mmicko/workshop_badge/badge.kicad_pcb

## KiCad design badge.kicad_pcb (2018-02-12)

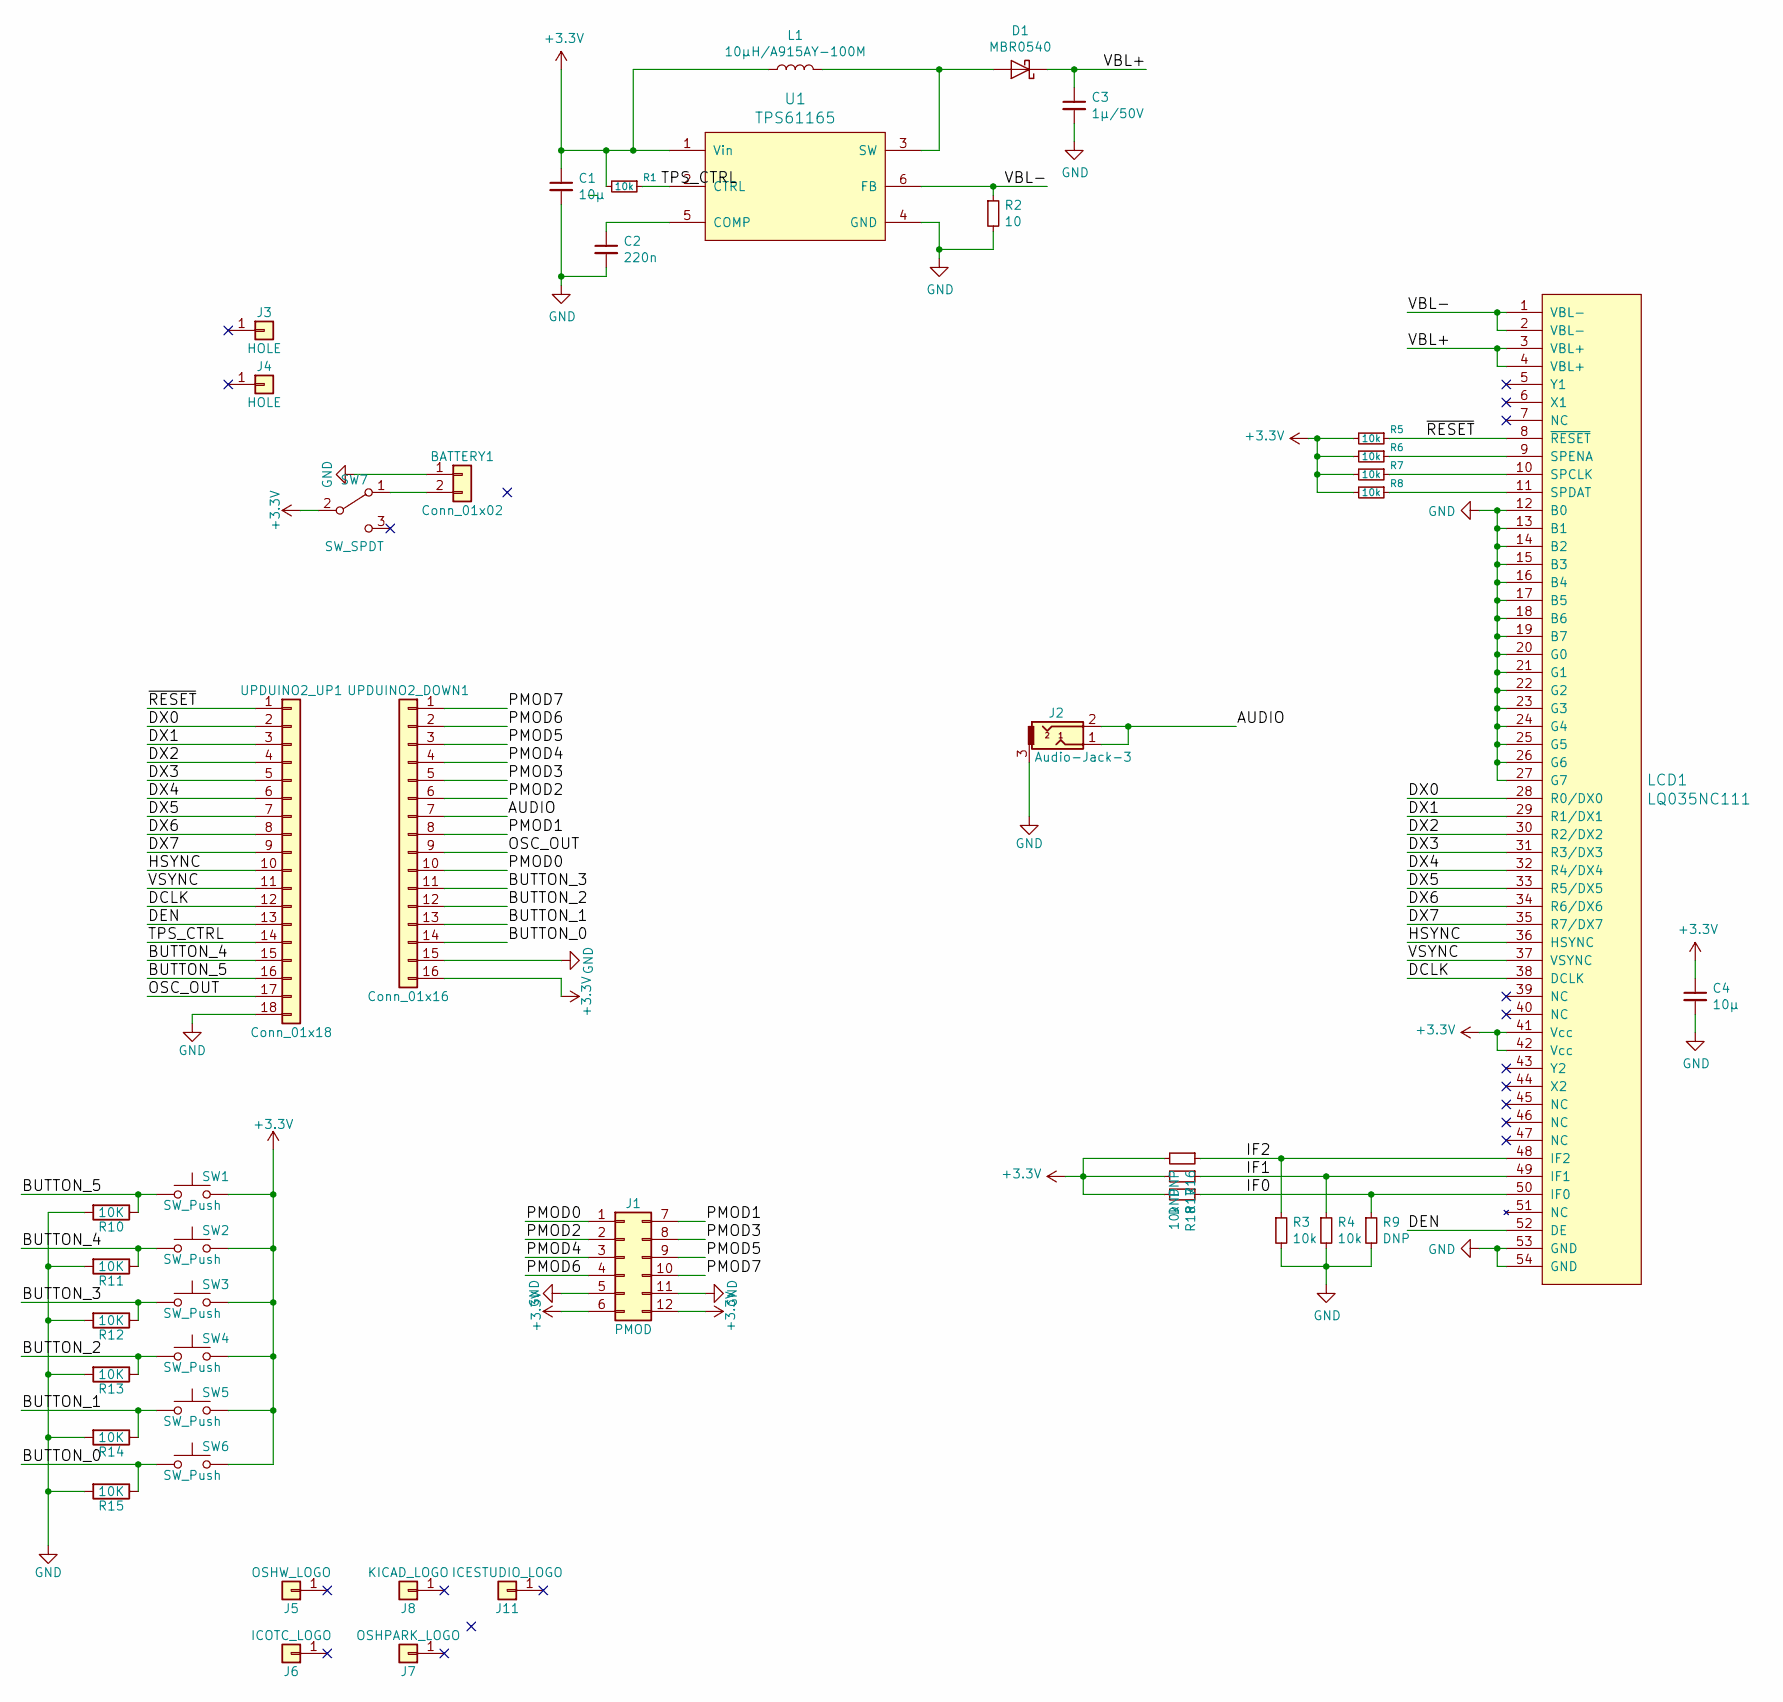
[picture p1: schematic badge.sch, FPGA Workshop Badge for Hackaday Belgrade 2018]

Parts:
BATTERY1: Conn_01x02; Pin_Header_Straight_1x02_Pitch2.54mm
C1, C4: 10µ; C_0805
C2: 220n; C_0603
C3: 1µ/50V; C_0805
D1: MBR0540; D_SOD-123
J1: PMOD; Pin_Header_Angled_2x06_Pitch2.54mm_PMOD
J2: Audio-Jack-3; AUDIO_JACK_3.5mm
J3, J4: HOLE; MountingHole_3.2mm_M3
J5: OSHW_LOGO; OSHW-Logo2_24.3x20mm_SilkScreen
J6: ICOTC_LOGO; ICOTC
J7: OSHPARK_LOGO; OSHPARK
J8: KICAD_LOGO; KiCad-Logo_12mm_SilkScreen
J11: ICESTUDIO_LOGO; ICESTUDIO
L1: 10µH/A915AY-100M; muRata_L_2020
LCD1: LQ035NC111; MOLEX_51296-5494_54pin_0.5mm_BTM
R1, R3, R4, R5, R6, R7, R8, R18: 10k; R_0603
R2: 10; R_0603
R9, R16, R17: DNP; R_0603
R10, R11, R12, R13, R14, R15: 10K; R_0603
SW1, SW2, SW3, SW4, SW5, SW6: SW_Push; SW_PUSH-12mm
SW7: SW_SPDT; SW_CuK_OS102011MA1QN1_SPDT_Angled
U1: TPS61165; SOT-23-6
UPDUINO2_DOWN1: Conn_01x16; Pin_Header_Straight_1x16_Pitch2.54mm
UPDUINO2_UP1: Conn_01x18; Pin_Header_Straight_1x18_Pitch2.54mm

Connections:
+3V3: C1.1, C4.1, J1.6, J1.12, L1.1, LCD1.41 (Vcc), LCD1.42 (Vcc), R1.2, R5.2, R6.2, R7.2, R8.2, R16.2, R17.2, R18.2, SW1.2, SW2.2, SW3.2, SW4.2, SW5.2, SW6.2, SW7.2 (B), U1.1 (Vin), UPDUINO2_DOWN1.16
/AUDIO: J2.1, J2.2, UPDUINO2_DOWN1.7
/BUTTON_0: R15.1, SW6.1, UPDUINO2_DOWN1.14
/BUTTON_1: R14.1, SW5.1, UPDUINO2_DOWN1.13
/BUTTON_2: R13.1, SW4.1, UPDUINO2_DOWN1.12
/BUTTON_3: R12.1, SW3.1, UPDUINO2_DOWN1.11
/BUTTON_4: R11.1, SW2.1, UPDUINO2_UP1.15
/BUTTON_5: R10.1, SW1.1, UPDUINO2_UP1.16
/DCLK: LCD1.38 (DCLK), UPDUINO2_UP1.12
/DEN: LCD1.52 (DE), UPDUINO2_UP1.13
/DX0: LCD1.28 (R0/DX0), UPDUINO2_UP1.2
/DX1: LCD1.29 (R1/DX1), UPDUINO2_UP1.3
/DX2: LCD1.30 (R2/DX2), UPDUINO2_UP1.4
/DX3: LCD1.31 (R3/DX3), UPDUINO2_UP1.5
/DX4: LCD1.32 (R4/DX4), UPDUINO2_UP1.6
/DX5: LCD1.33 (R5/DX5), UPDUINO2_UP1.7
/DX6: LCD1.34 (R6/DX6), UPDUINO2_UP1.8
/DX7: LCD1.35 (R7/DX7), UPDUINO2_UP1.9
/HSYNC: LCD1.36 (HSYNC), UPDUINO2_UP1.10
/IF0: LCD1.50 (IF0), R9.1, R18.1
/IF1: LCD1.49 (IF1), R4.1, R17.1
/IF2: LCD1.48 (IF2), R3.1, R16.1
/OSC_OUT: UPDUINO2_DOWN1.9, UPDUINO2_UP1.17
/PMOD0: J1.1, UPDUINO2_DOWN1.10
/PMOD1: J1.7, UPDUINO2_DOWN1.8
/PMOD2: J1.2, UPDUINO2_DOWN1.6
/PMOD3: J1.8, UPDUINO2_DOWN1.5
/PMOD4: J1.3, UPDUINO2_DOWN1.4
/PMOD5: J1.9, UPDUINO2_DOWN1.3
/PMOD6: J1.4, UPDUINO2_DOWN1.2
/PMOD7: J1.10, UPDUINO2_DOWN1.1
/TPS_CTRL: R1.1, U1.2 (CTRL), UPDUINO2_UP1.14
/VBL+: C3.1, D1.1 (K), LCD1.3 (VBL+), LCD1.4 (VBL+)
/VBL-: LCD1.1 (VBL-), LCD1.2 (VBL-), R2.1, U1.6 (FB)
/VSYNC: LCD1.37 (VSYNC), UPDUINO2_UP1.11
/~RESET: LCD1.8 (~RESET), R5.1, UPDUINO2_UP1.1
GND: BATTERY1.1, C1.2, C2.2, C3.2, C4.2, J1.5, J1.11, J2.3, LCD1.12 (B0), LCD1.13 (B1), LCD1.14 (B2), LCD1.15 (B3), LCD1.16 (B4), LCD1.17 (B5), LCD1.18 (B6), LCD1.19 (B7), LCD1.20 (G0), LCD1.21 (G1), LCD1.22 (G2), LCD1.23 (G3), LCD1.24 (G4), LCD1.25 (G5), LCD1.26 (G6), LCD1.27 (G7), LCD1.53 (GND), LCD1.54 (GND), R2.2, R3.2, R4.2, R9.2, R10.2, R11.2, R12.2, R13.2, R14.2, R15.2, U1.4 (GND), UPDUINO2_DOWN1.15, UPDUINO2_UP1.18
unnamed: BATTERY1.2, SW7.1 (A)
unnamed: C2.1, U1.5 (COMP)
unnamed: D1.2 (A), L1.2, U1.3 (SW)
unnamed: LCD1.9 (SPENA), R6.1
unnamed: LCD1.10 (SPCLK), R7.1
unnamed: LCD1.11 (SPDAT), R8.1

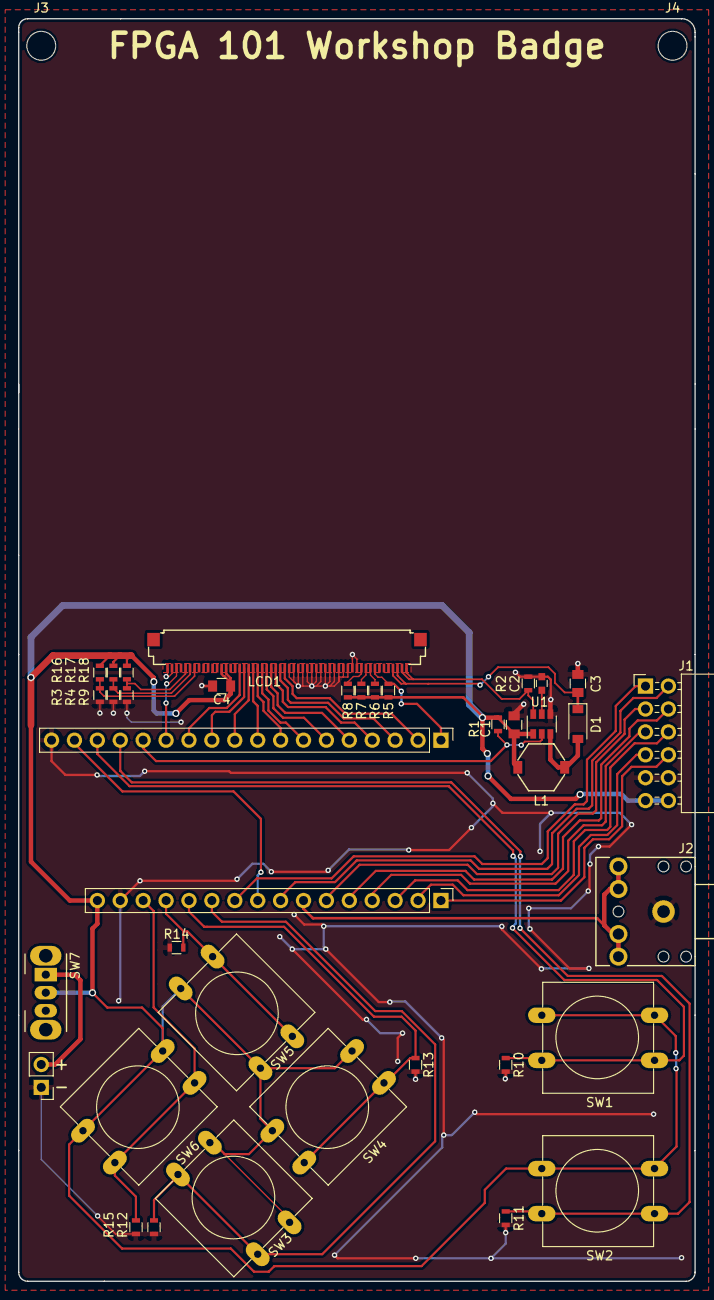
[picture p2: board badge.kicad_pcb from above]

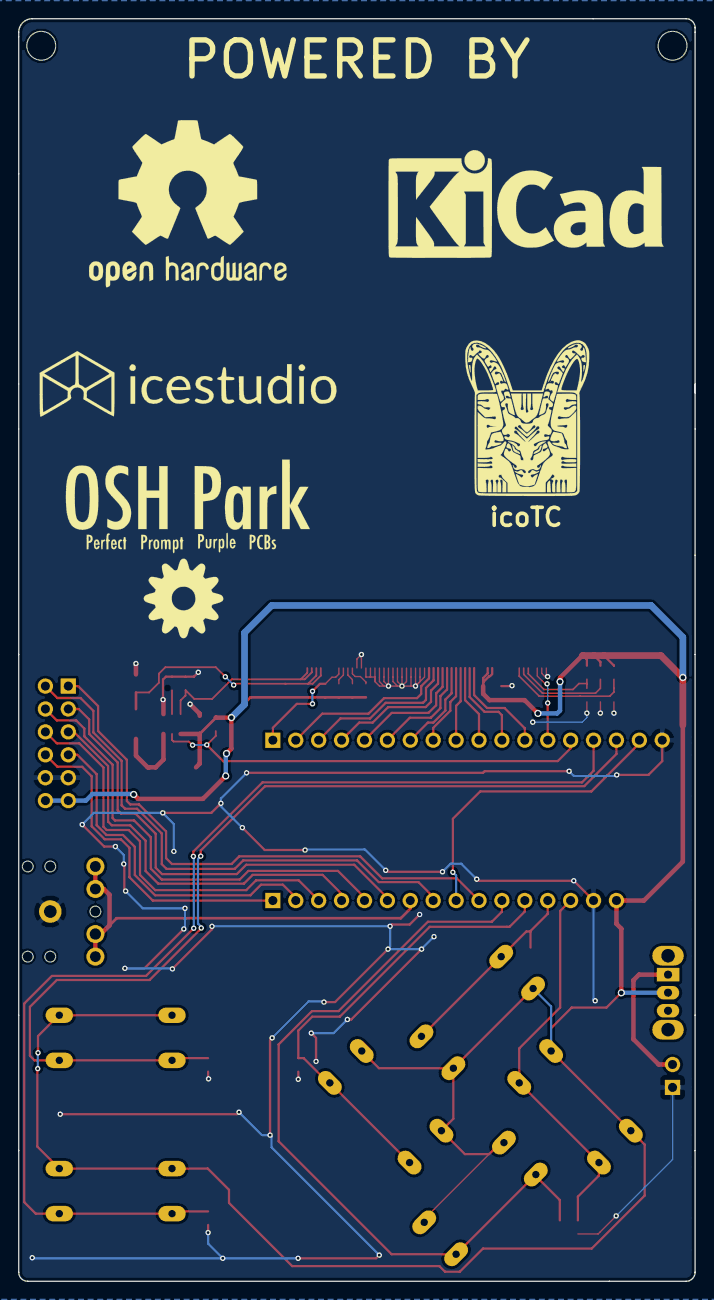
[picture p3: board badge.kicad_pcb from below]

Board: 2 copper layers, 75.0 x 140.0 mm, 45 parts (5 on the bottom side), 43 nets.
