mmicko/workshop_badge/lcd_test/video.v

module lcdtest (input clk, //19.2MHz pixel clock in
                input resetn,
                output reg [7:0] lcd_dat,
                output reg lcd_hsync,
                output reg lcd_vsync,
                output reg lcd_den);
              
            
parameter h_visible = 10'd320;
parameter h_front = 10'd20;
parameter h_sync = 10'd30;
parameter h_back = 10'd38;
parameter h_total = h_visible + h_front + h_sync + h_back;

parameter v_visible = 10'd240;
parameter v_front = 10'd4;
parameter v_sync = 10'd3;
parameter v_back = 10'd15;
parameter v_total = v_visible + v_front + v_sync + v_back;

reg [1:0] channel = 0;
reg [9:0] h_pos = 0;
reg [9:0] v_pos = 0;

wire h_active, v_active, visible;
wire [23:0] rgb_data;

always @(posedge clk) 
begin
  if (resetn == 0) begin
    h_pos <= 10'b0;
    v_pos <= 10'b0;

  end else begin
    //Pixel counters
    if (channel == 2) begin
      channel <= 0;
      if (h_pos == h_total - 1) begin
        h_pos <= 0;
        if (v_pos == v_total - 1) begin
          v_pos <= 0;
        end else begin
          v_pos <= v_pos + 1;
        end
      end else begin
        h_pos <= h_pos + 1;
      end
    end else begin
      channel <= channel + 1;
    end
    lcd_den <= !visible;
    lcd_hsync <= !((h_pos >= (h_visible + h_front)) && (h_pos < (h_visible + h_front + h_sync)));
    lcd_vsync <= !((v_pos >= (v_visible + v_front)) && (v_pos < (v_visible + v_front + v_sync)));
    lcd_dat <= channel == 0 ? rgb_data[23:16] : 
               channel == 1 ? rgb_data[15:8]  :
               rgb_data[7:0];
  end
end

assign h_active = (h_pos < h_visible);
assign v_active = (v_pos < v_visible);
assign visible = h_active && v_active;

assign rgb_data = (h_pos < 64)  ? {h_pos[5:0], 18'd0} :
                  (h_pos < 128) ? {8'd0, h_pos[5:0], 10'd0} :
                  (h_pos < 192) ? {16'd0, h_pos[5:0], 2'd0} :
                  (h_pos < 256) ? {h_pos[5:0], 2'd0, h_pos[5:0], 2'd0, h_pos[5:0], 2'd0} :
                  (h_pos < 320) ? {h_pos[5:0], 2'd0, 8'd0, h_pos[5:0], 2'd0} :
                  24'd0;

endmodule
