mmicko/workshop_badge/(commit log)

2018-02-10 Added initial schematics, import part from David PMOD LCD35 project
    [badge.kicad_pcb, badge.sch]
2018-02-10 Make extension half pmod, and left one led, added battery switch.
    [badge.sch]
2018-02-10 removed SPI on LED to optimize, drive TPS control, 2 leds on dedicated PLL ports
    [badge.sch]
2018-02-10 Made audio mono and using pin 37, change port to PMOD, clk on proper pin,
    [badge.sch]
2018-02-10 Footprint assignments and initial placement
    [badge.kicad_pcb, badge.sch]
2018-02-11 Routing done and logos added
    [badge.kicad_pcb, badge.sch]
2018-02-12 Final tweaks, create gerbers
    [badge-B.Cu.gbl, badge-B.Mask.gbs, badge-B.SilkS.gbo, badge-Edge.Cuts.gm1, badge-F.Cu.gtl, badge-F.Mask.gts, badge-F.SilkS.gto, badge.drl]
2018-03-28 Added initial mikroBus board design
    [mikrobus-board.kicad_pcb, mikrobus-board.sch]
2018-03-28 update connector
    [mikrobus-board.kicad_pcb, mikrobus-board.sch]
2018-03-28 better placing
    [mikrobus-board.kicad_pcb]
2018-03-28 Finished routing
    [mikrobus-board.kicad_pcb, mikrobus-board.sch]
2018-03-29 Simpler routing
    [mikrobus-board.kicad_pcb, mikrobus-board.sch]
2018-03-29 Power lines and better routing for power lines
    [mikrobus-board.kicad_pcb]
2018-03-29 Finished design
    [mikrobus-board.kicad_pcb]
2018-03-29 Fixed silk
    [mikrobus-board.kicad_pcb]
2018-03-29 Added gerber files for mikrobus board
    [mikrobus-board-B.Cu.gbr, mikrobus-board-B.Mask.gbr, mikrobus-board-B.SilkS.gbr, mikrobus-board-Edge.Cuts.gbr, mikrobus-board-F.Cu.gbr, mikrobus-board-F.Mask.gbr, mikrobus-board-F.SilkS.gbr, mikrobus-board.drl]
2018-05-17 Remove files not belonging here
    [mikrobus-board-B.Cu.gbr, mikrobus-board-B.Mask.gbr, mikrobus-board-B.SilkS.gbr, mikrobus-board-Edge.Cuts.gbr, mikrobus-board-F.Cu.gbr, mikrobus-board-F.Mask.gbr, mikrobus-board-F.SilkS.gbr, mikrobus-board.drl]
